matt-e0/CubeSat-Fault-Tolerant-Control/Control Theory/README.md

# Adaptive Sliding Mode Controller Design

The at heart of the system is the Adaptive Sliding Mode Controller (ASMC). ASMC was chosen over traditional control methods due the requirements of fault-tolerance for the attitude control system. This section will outline the theory behind the controller and the proofs used to verify the stability of the system. 

| Parameter | Description |
|---|---|
| `s` | Sliding surface |
| `lambda` | Sliding surface slope |
| `q` | Quaternion angle |
| `omega` | Rotational velocity |
| `J` | Inertia matrix |
| `tau` | Torque |
| `sigma` | Leakage coefficient |
| `Gamma` | Adaptive gain rate |
| `K/ K_adaptive` | Switching gain |
| `K_min` | Minimum switching gain |
| `K_max` | Maximum switching gain |

## Passive VS Active Fault Isolation

| Passive | Active |
|---|---|
| Inherently robust, doesn't require detection layer | More efficient distribution of torque, improved wheel health |
| Reduces processing load of microcontroller (no reaction wheel speed sensing or heavy matrix updates) | Can achieve a higher pointing accuracy during failures as feedback prevents overcompensation |
| Independent of fault-detection architecture, no risk for false-positives | System doesn't try to power faulty motors |

A passive fault-isolating control method was chosen as the project is aimed to integrate easily into existing satellite designs. The addition of a fault-detection and isolation program and the requirement for actuator feedback increases the complexity of the design and the load on the control electronics. The most promising passive controller is the ASMC, due to its high robustness and it's ability to linearise non-linear kinematics by defining a sliding surface.

<p align="center">
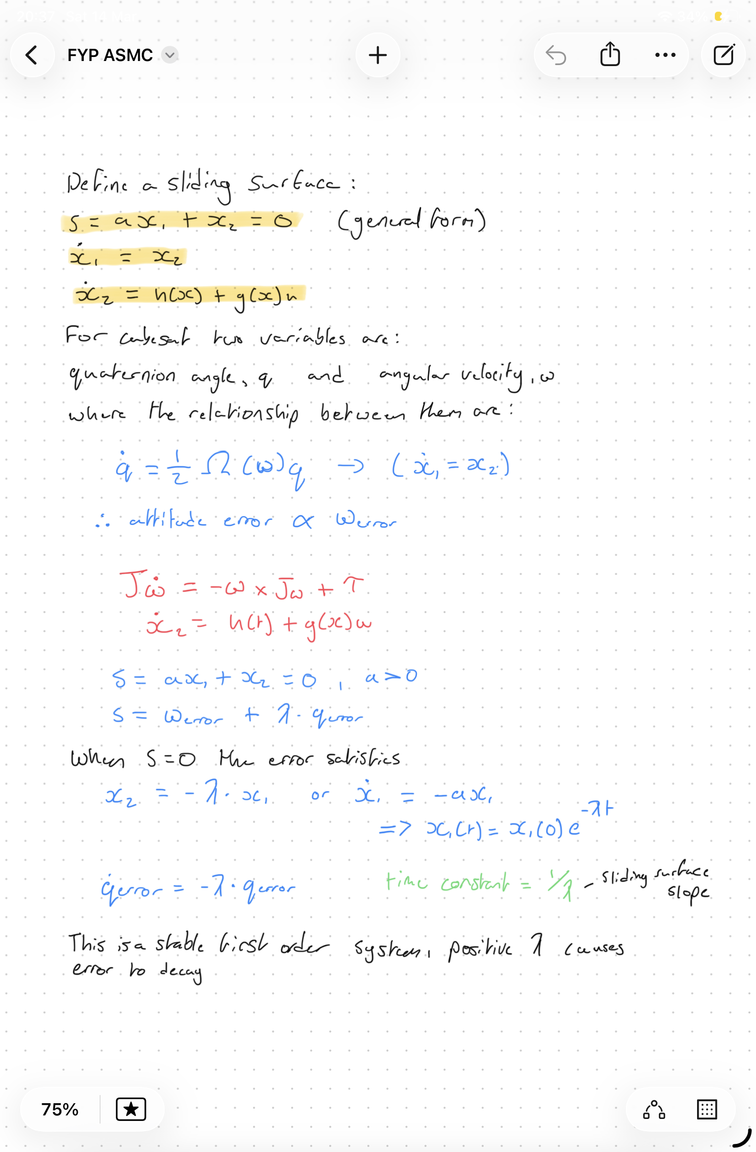
[picture p4: Resources/ControlTheory1.png]
  
  <br/>
  <em>ASMC Design - Page 1</em>
</p>

<p align="center">
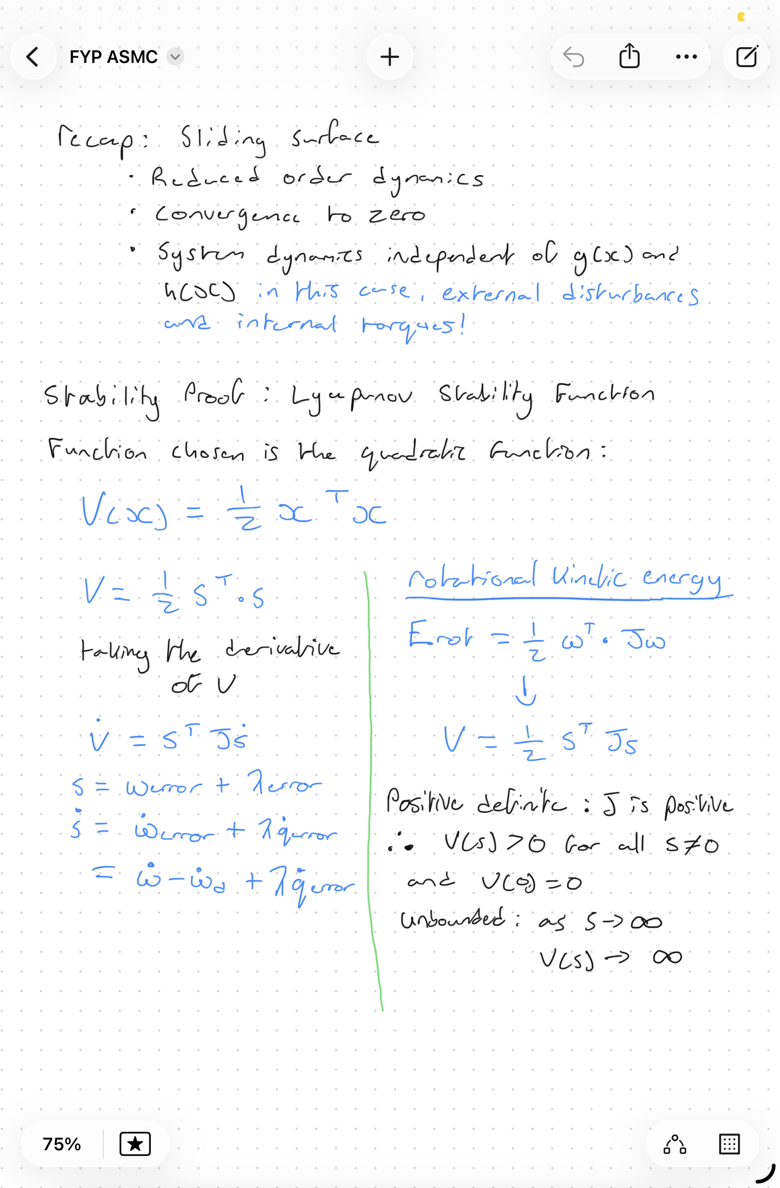
[picture p5: Resources/ControlTheory2.png]
  
  <br/>
  <em>ASMC Design - Page 2</em>
</p>

## Lyapunov Proof

In order to verify that the sliding mode controller is stable, the energy of the system is analysed using a Lyapunov Proof, in this case the Quadratic Function is chosen as the system dynamics aligns with the equation for rotational kinetic energy. By proving that the system's energy will decay, the controller is shown to be stable.

<p align="center">
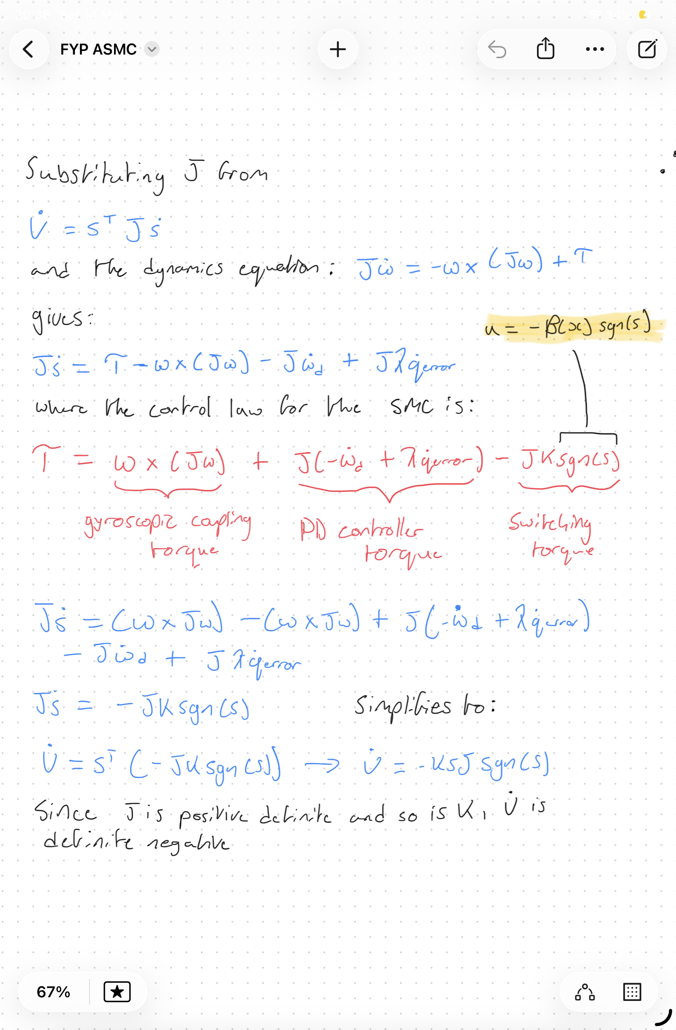
[picture p6: Resources/ControlTheory3.png]
  
  <br/>
  <em>ASMC Design - Page 3</em>
</p>

## Adaptive Gain Term

To overcome the limitations of a manually set gain, the gain of the sliding mode controller can be defined using an adaptive term, that increases at a rate tied to the norm 's' of the sliding surface (how far the system is from its point of stability) and decays over time to prevent the system from experiencing wind-up. The following equation ensures that the gain of the controller is bounded between two values, getting the best performance regardless of the current disturbance to the system.

<p align="center">
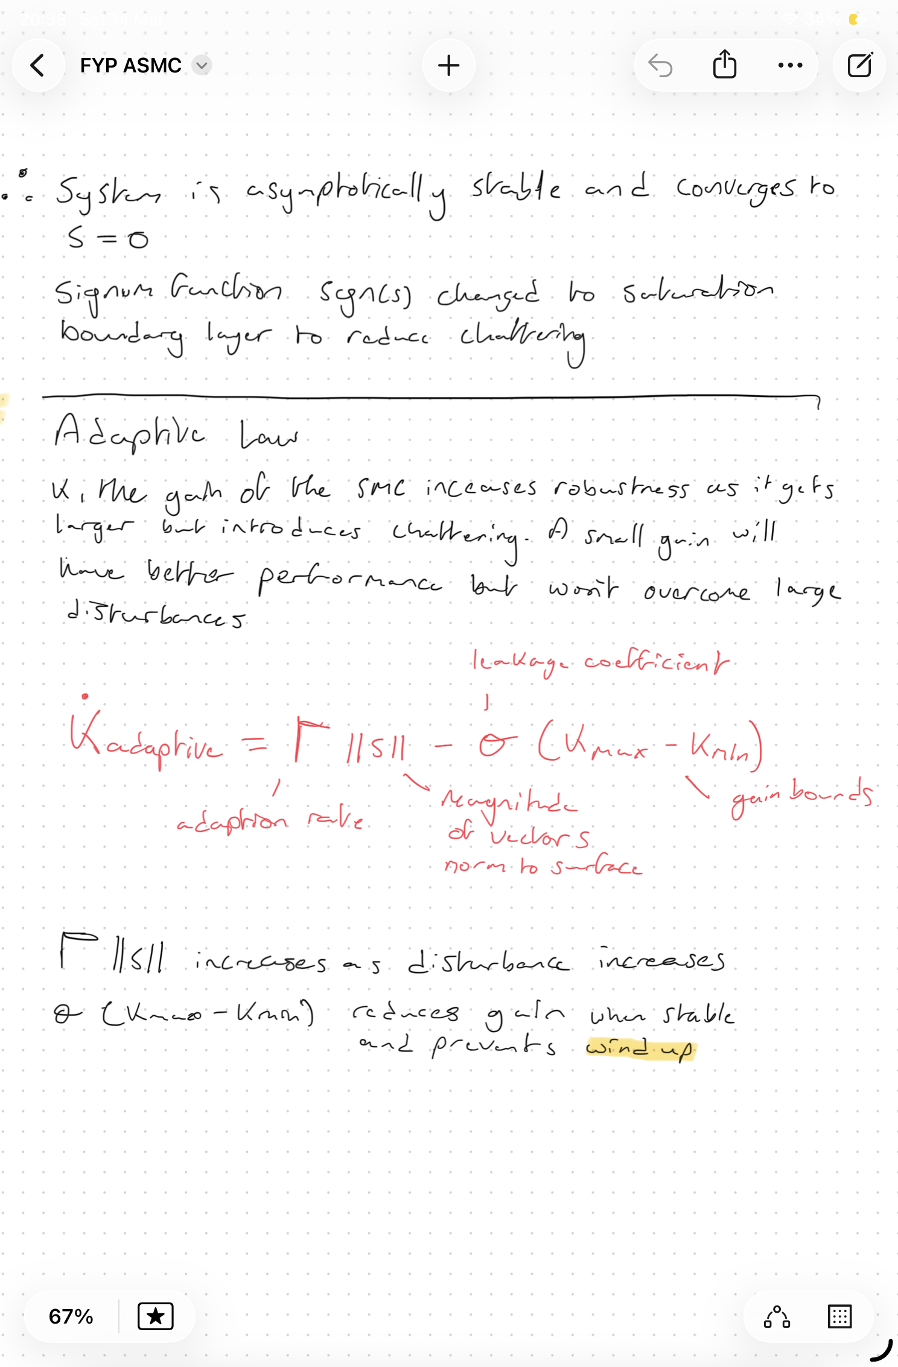
[picture p7: Resources/ControlTheory4.png]
  
  <br/>
  <em>ASMC Design - Page 4</em>
</p>

<p align="center">
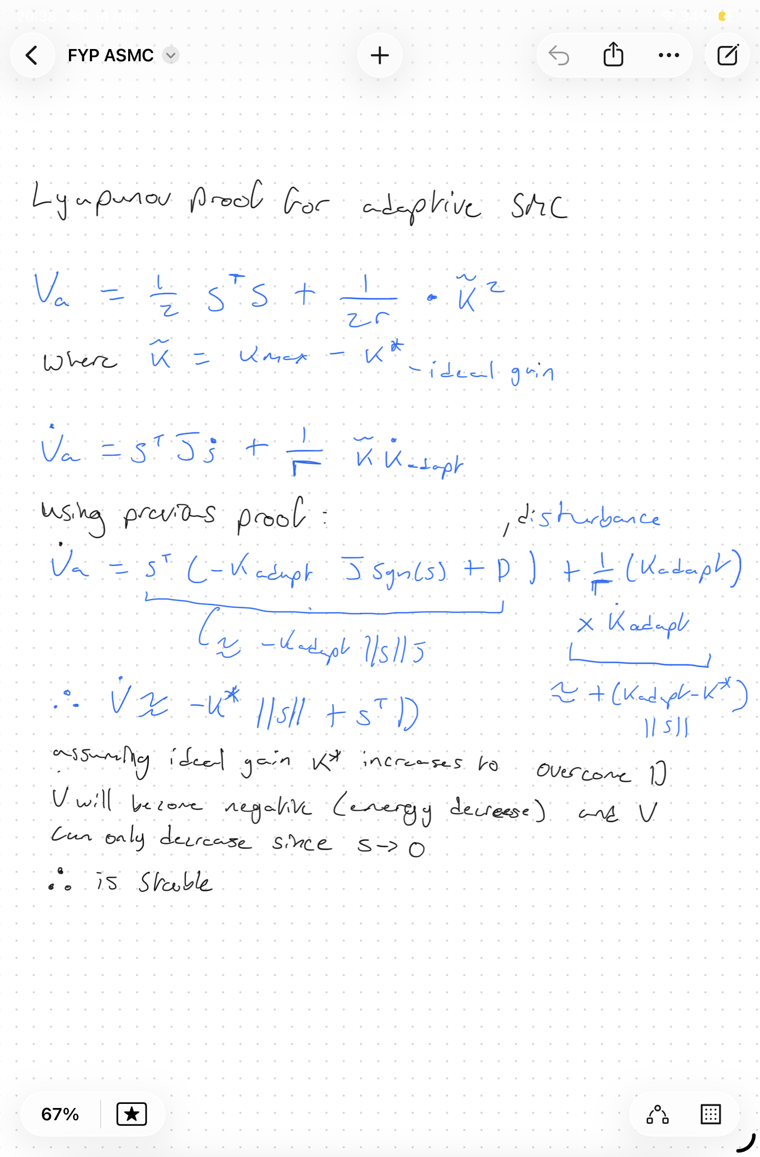
[picture p8: Resources/ControlTheory5.png]
  
  <br/>
  <em>ASMC Design - Page 5</em>
</p>

## Previous Designs & Improvements

Initially this project aimed to implement a PD controller coupled with a Fault-Detection and Isolation (FDI) program to redistribute torque based on the determined health of a reaction wheel. This was decided against as mentioned previously, a passive FDI method was preferred. After that some work on Linear Quadratic Control was explored, but never fully implemented. Both controller can be found in the log book data, with both being evaluated in Simulink using the URDF model under Mechanical. Both showed some promise but were scrapped in favour of ASMC. Furthermore, the Simulink model and URDF were evaluated and found to be unstable, causing most controllers to 'runaway' and fail. The simulation file abandoned as a result, and the design continued in MATLAB.

Currently, large flaw with the implementation of this controller is that Euler integration is used to update K_adapt += K_adapt_dot * dt. This method provides a discretisation error, which may cause the system to deviate from the expected behaviour modelled above, since the Lyapunov proof is modelled in continuous time. Due to the controller running at 100Hz and the slow dynamics of the reaction wheels, this does not cause any issues in practice.
