matt-e0/CubeSat-Fault-Tolerant-Control/Initial Planning & Rough Work/FinalYearProject.docx

Draft:

Project: LASER – Design and simulation of CubeSat ADCS with Fault Tolerance

Idea: Build an Attitude Determination and Control System that is small enough to be used in a 3U CubeSat. The system will need to be able to perform regular stabilisation and attitude adjustment manoeuvres and as an extension, should be able to use fault detection or AI for adaptive control given a failure or degradation in performance.

Maybe build a magnetorquer demo??

https://www.youtube.com/watch?v=cGJYCe6mGR0

Fault detection:

Rule based:

Monitor speed of RW, if no response to command set flag

AI-Based anomaly detection:

Train a simple AI model on wheel speed, command signal and angular rate mismatch (gyro vs expected from control)

Control System

https://iopscience.iop.org/article/10.1088/1742-6596/2355/1/012035/pdf

https://www.researchgate.net/publication/348690743_PID_CONTROLLER_DESIGN_FOR_THE_SATELLITE_ATTITUDE_CONTROL_SYSTEM

Simulate faults in software or simulation

https://ieeexplore.ieee.org/abstract/document/1627602

Reaction Wheel Module:

There are many methods for attitude control. Some notable methods are using; reaction wheels, control moment gyroscopes and reaction spheres. Reaction spheres are an advanced method of control that requires the magnetic levitation of an inductive sphere, which can then be manipulated using an array of electromagnets to generate torque. CITATION This method requires advanced manufacturing techniques and isn’t well suited to CubeSats despite the volume efficiency of such a design. CITATION Control Moment Gyroscopes (CMGs) are often used in larger space craft as they are very power efficient when compared to traditional reaction wheels. Citation. This is because a CMG will spin a rotor but rotate its control axis to change the direction of the induced torque. Reaction wheels have been a popular choice for spacecraft designers since the dawn of the space age. They work by rotating a flywheel to generate a moment of inertia that can be used to torque the spacecraft along an axis. This angular momentum can be used to manoeuvre a spacecraft… blah blah blah. Each reaction wheel has an upper limit to its flywheel speed and therefore a limit on how much inertia it can provide to counteract a spacecrafts angular momentum. This can be an issue if the angular momentum of a spacecraft far exceeds the inertia of the reaction wheel, and an external detumbling device such as a magnetorquer is required. * Explain detumbling…

For the LASER CubeSat a brushless motor was decided to be optimal as most brushed motors experience arcing in the vacuum of space and rapidly degrade when used. For this reason, a small brushless DC motor used for racing drones was chosen the _________. A drone motor was chosen over a commercial BLDC as they are much cheaper than similarly sized commercial motors and offer incredible performance relative to weight. One drawback is the power consumption but it can be limited for drone use. Small. High rpm -→ flywheel design for compact reaction wheel… etc. Relevant ESCs chosen due to compact footprint and ease of use. Reaction wheel needs to measure rotational speed, hall sensor chosen as it is compact cheap and reliable (optical encounters dust). Magnets to be placed in flywheel.

https://iopscience.iop.org/article/10.1088/1742-6596/2355/1/012035/pdf

https://www.researchgate.net/publication/348690743_PID_CONTROLLER_DESIGN_FOR_THE_SATELLITE_ATTITUDE_CONTROL_SYSTEM

https://www.unoosa.org/documents/pdf/psa/access2space4all/KiboCUBE/AcademySeason2/On-demand_Pre-recorded_Lectures/KiboCUBE_Academy_2021_OPL14.pdf

https://s3vi.ndc.nasa.gov/ssri-kb/static/resources/Attitude%20Determination%20&%20Control%20System%20Design%20and%20Implementation.pdf

https://ieeexplore.ieee.org/abstract/document/1627602

https://www.sciencedirect.com/science/article/pii/S0967066123000850

https://www.youtube.com/watch?v=MBX_xa2xRDg

file:///C:/Users/matt/Downloads/cubesat.pdf

https://commons.erau.edu/cgi/viewcontent.cgi?article=1707&context=discovery-day

https://s3vi.ndc.nasa.gov/ssri-kb/static/resources/Wolosik_AT_T_2018.pdf?

This one needs to be read ^^^^^
