matt-e0/CubeSat-Fault-Tolerant-Control/Resources/1000030336.jpg

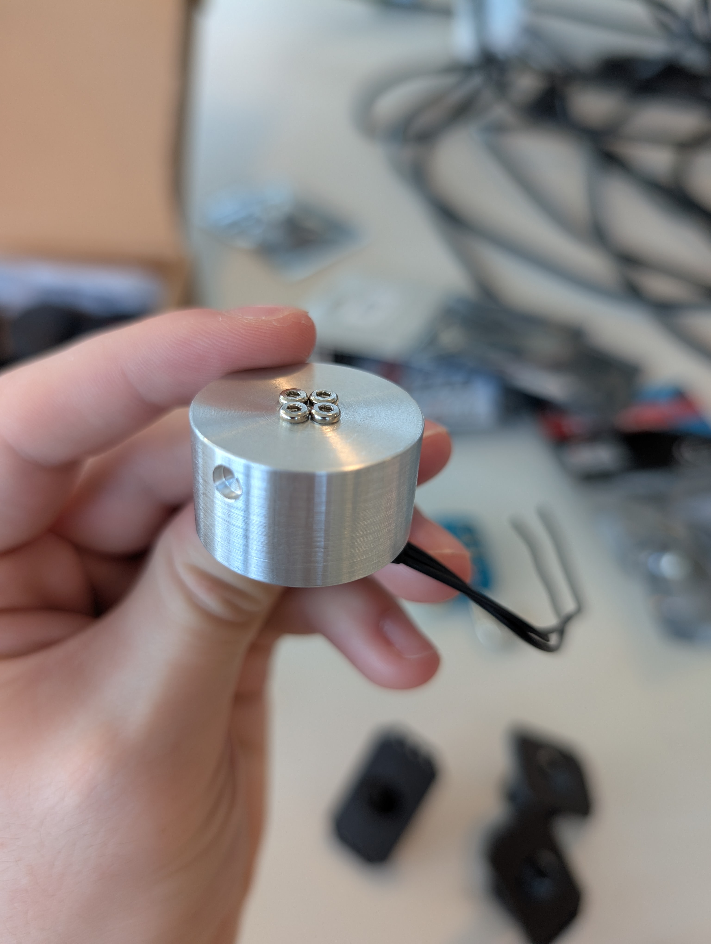
Resources/1000030336.jpg
