matt-e0/CubeSat-Fault-Tolerant-Control/Resources/1000038969.jpg

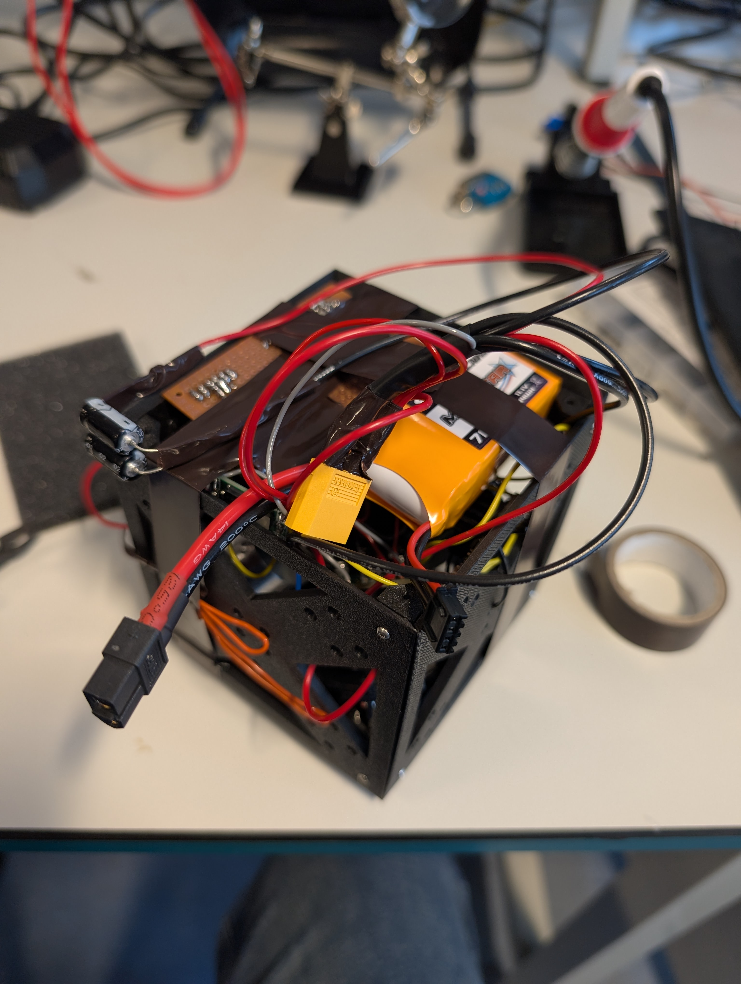
Resources/1000038969.jpg
