matt-e0/CubeSat-Fault-Tolerant-Control/Resources/Gain response Sim.png

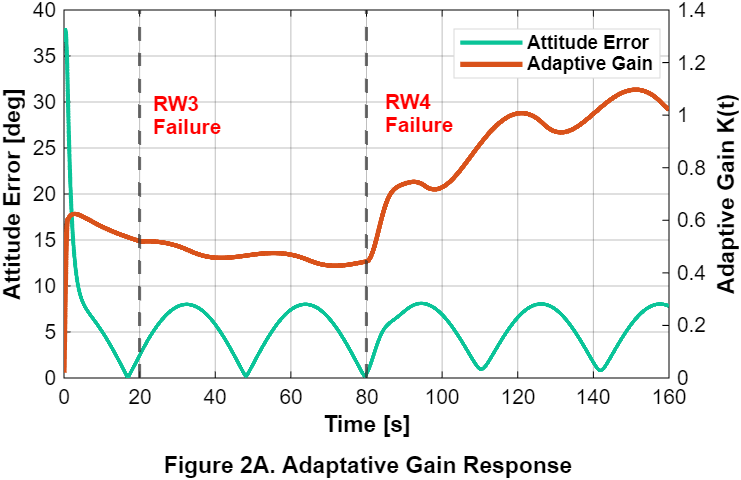
Resources/Gain response Sim.png
