matt-e0/CubeSat-Fault-Tolerant-Control/Simulation/meshes/wheel1.stl

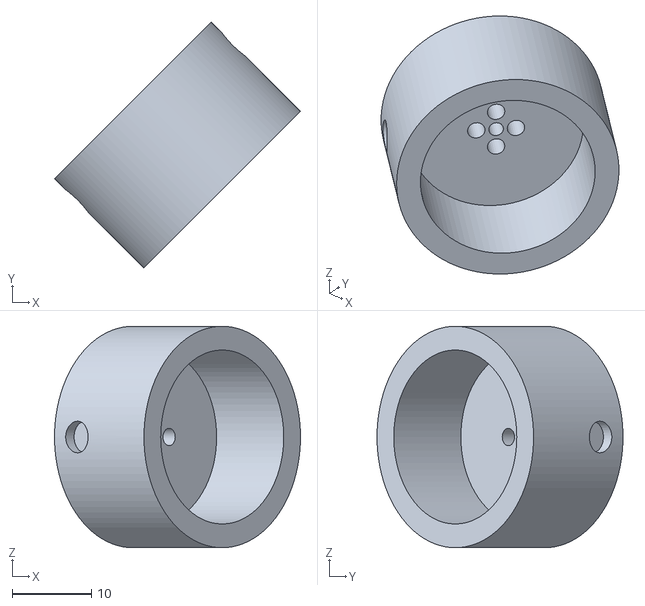
[picture p37: CAD file, 2026-03-14]
Simulation/meshes/wheel1.stl
31.1 x 31.1 x 28.0
