matt-e0/CubeSat-Fault-Tolerant-Control/Simulation/meshes/frame.stl

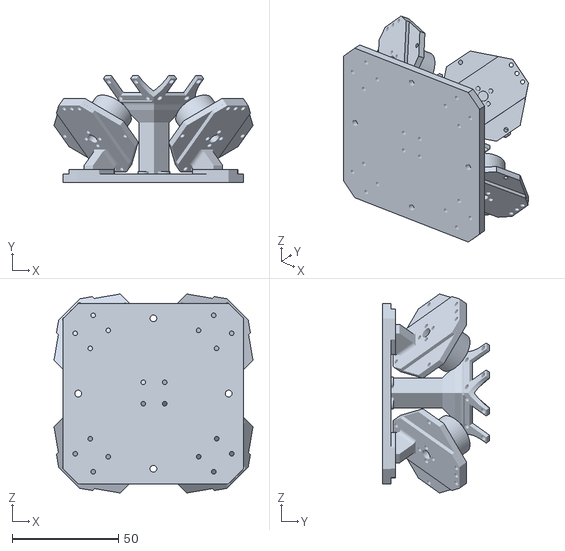
[picture p38: CAD file, 2026-03-13]
Simulation/meshes/frame.stl
93.5 x 50.1 x 93.5
