matt-e0/CubeSat-Fault-Tolerant-Control/(list of files, cad)

Other CAD files:
Simulation/meshes/wheel2.stl
Simulation/meshes/wheel4.stl
Simulation/meshes/wheel3.stl
