matt-e0/CubeSat-Fault-Tolerant-Control/Mechanical/URDF/FYPSTEP.urdf

<?xml version='1.0' encoding='utf-8'?>
<robot name="FYPSTEP">
    <link name="Component24">
        <inertial>
            <origin xyz="0.024778929265476483 0.01358847674705627 0.024749238958771885" rpy="0.0 0.0 0.0" />
            <mass value="0.08707568321144665" />
            <inertia ixx="6.802072810697727e-05" iyy="0.00010595150186318194" izz="6.801448308761863e-05" ixy="-3.339804086079475e-08" iyz="-1.4312952361884227e-08" ixz="2.122187505880415e-08" />
        </inertial>
        <visual name="Component24_visual">
            <origin xyz="0.0 0.0 0.0" rpy="0.0 0.0 0.0" />
            <geometry>
                <mesh filename="meshes/Component24.stl" scale="0.001 0.001 0.001" />
            </geometry>
        </visual>
        <collision name="Component24_collision">
            <origin xyz="0.0 0.0 0.0" rpy="0.0 0.0 0.0" />
            <geometry>
                <mesh filename="meshes/Component24.stl" scale="0.001 0.001 0.001" />
            </geometry>
        </collision>
    </link>
    <link name="Component2">
        <inertial>
            <origin xyz="-0.0015448778670834418 0.0007093517731754351 -0.0016236316179086164" rpy="0.0 -2.7755575615628914e-17 2.7755575615628914e-17" />
            <mass value="0.013991570671585008" />
            <inertia ixx="1.506873944452866e-06" iyy="1.2974399382832934e-06" izz="1.5287114398049686e-06" ixy="-1.1325547808846402e-07" iyz="-1.306136846512623e-07" ixz="2.7039825575356107e-07" />
        </inertial>
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
        <parent link="Component24" />
        <child link="Component8" />
        <axis xyz="-0.7005231708600427 -0.502982531775134 0.5062357238088475" />
    </joint>
</robot>
